Iftu119/capacitance-meter/README.md

# Digital Capacitance Meter
“Digital Capacitance Meter” is a device that can determine the capacitance of an unknown capacitor to a certain extent of precision. Here, capacitance is a
term that describes the inherent property of a capacitor which is the electric charge stored with respect to a potential difference where two parallel plate conductors are used maintaining dielectric between them. Usually we get the measurement of capacitance via RLC meter which can determine the values of capacitance(C) along with the R and L which are resistance and inductance respectively.

### 🔰 Code 
We uploaded this [Code](https://github.com/Iftu119/capacitance-meter/blob/main/Capacitance-meter-code.ino) to the **ATMega328P** via Arduino Uno board. Later that IC had been removed from the Uno and used independently with the project without the assistance of arduino board. 

### 🔰 Report 
The [report](https://github.com/Iftu119/capacitance-meter/blob/main/Digital%20Capacitance%20Meter.pdf) has been made publicly available to to help other students provide a guideline on the basic framework. **Please do not copy entirely or partially from this document** 

## 🔰 Flowchart 
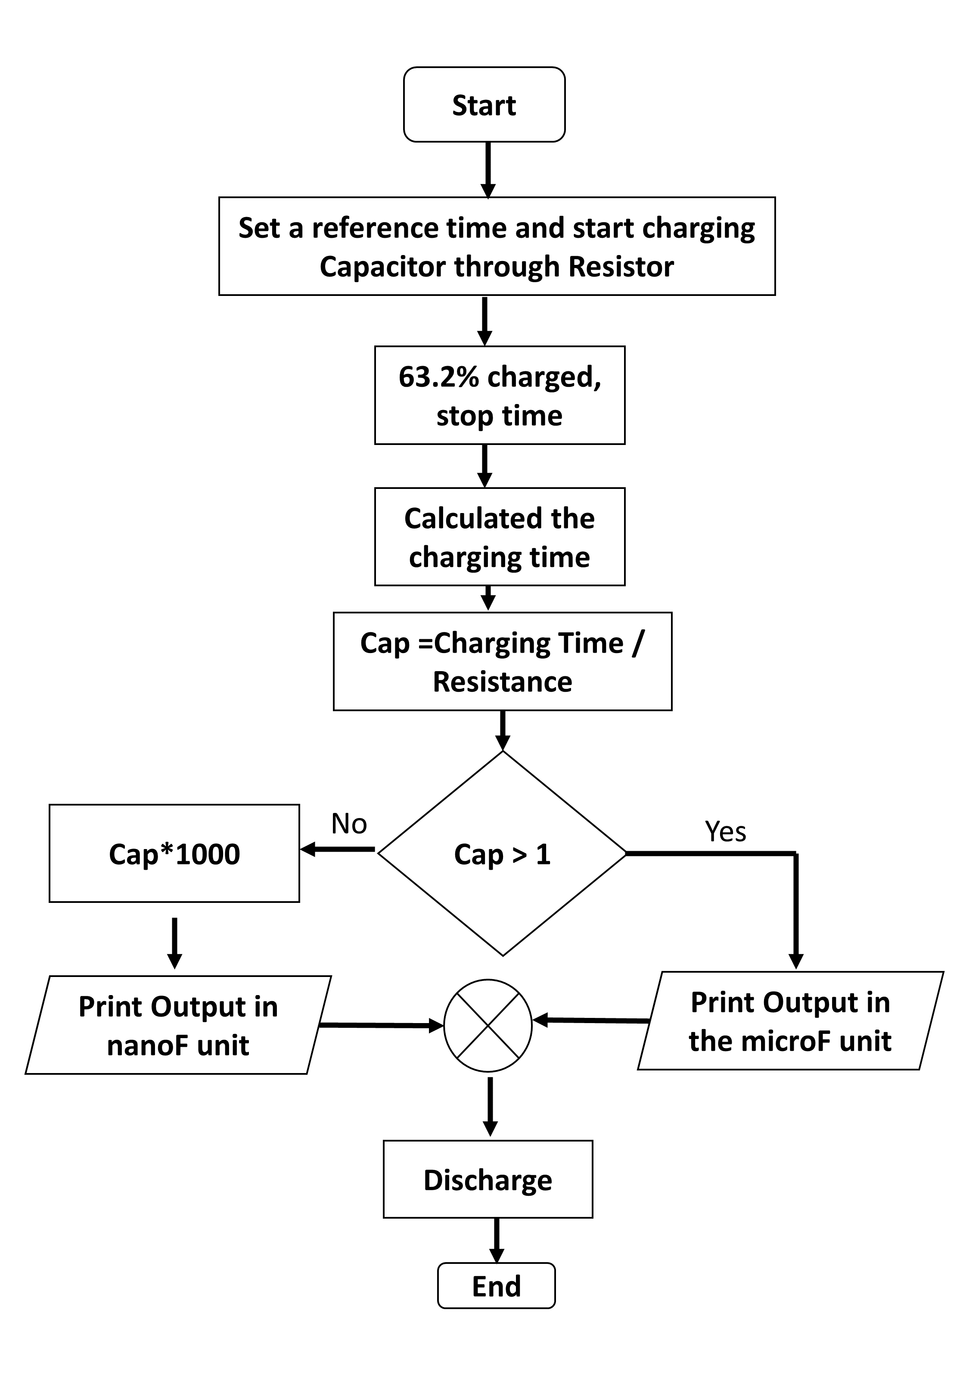
[picture p1: Flowchart-white.png]
flowchart for the dogotal capacutance meter


## 🔰 Circuit Diagram 
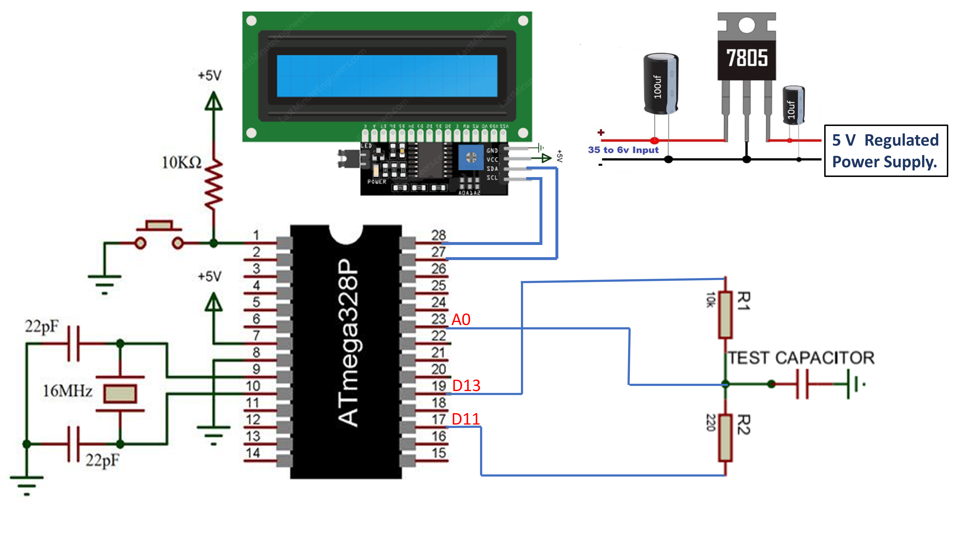
[picture p2: Ckt Diagram.png]
Circuit diagram for the digital capacitance meter


## 🔰 Hardware
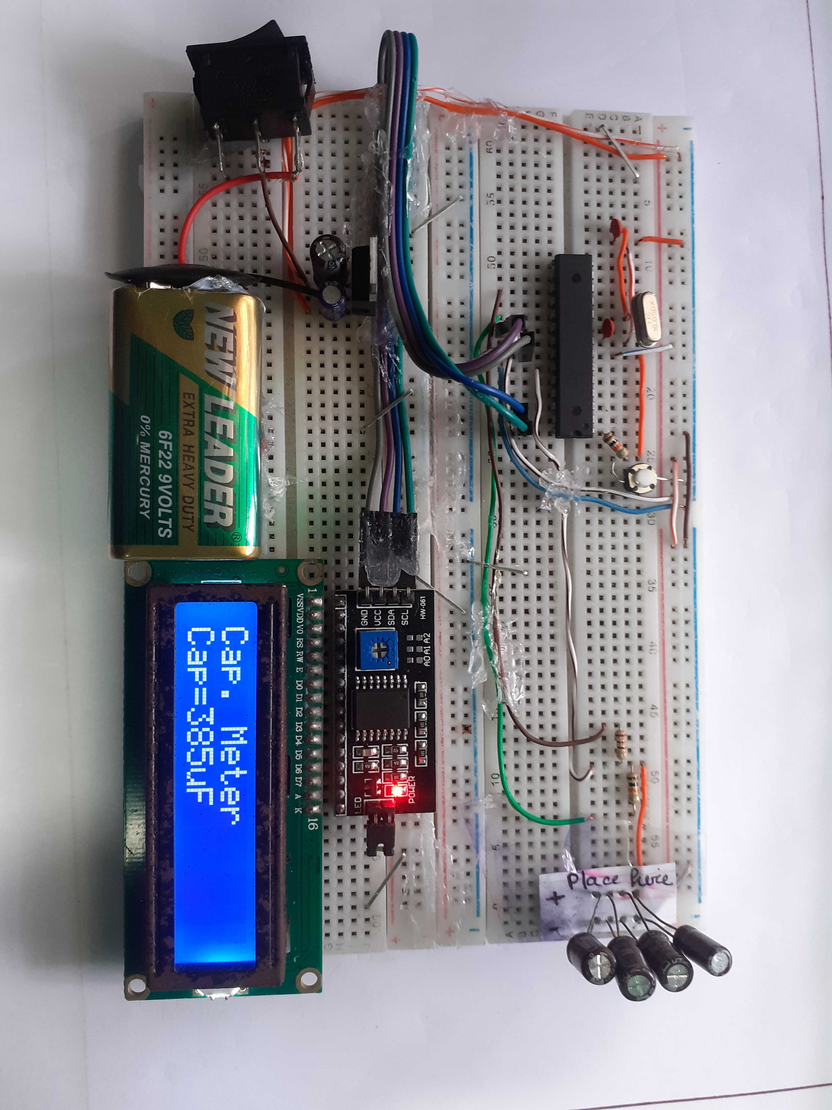
[picture p3: Project Hardware Setup.jpg]
Project hardware


### ⭐ Credit 
1. Ajmal Ahmed Shakib
2. Mohammad Iftekher (Iftu) Ebne Jalal 
3. Md Shoaibur Rahman

*For any queries, please add an issue to this respository.*
